jgOhYeah/TractorWatchdog/README.md

# TractorWatchdog
Engine watchdog for a Fordson Dexta tractor. Should work with other tractors as well.

Doxygen documentation is available [here](https://jgohyeah.github.io/TractorWatchdog/).

## Block diagram
Bloack diagram of the system
