jgOhYeah/TractorWatchdog/WatchdogMainUnit/Readme.md

# This CAD file contains the following models from external sources:
- [L298N motor driver](https://grabcad.com/library/l298n-21), downloaded 13/10/2023.
- [Automotive relay](https://grabcad.com/library/12v-40a-4-pin-car-relay-1), downloaded 27/12/2023.
