jgOhYeah/TractorWatchdog/WatchdogDashboard/Exports/Dashboard.step

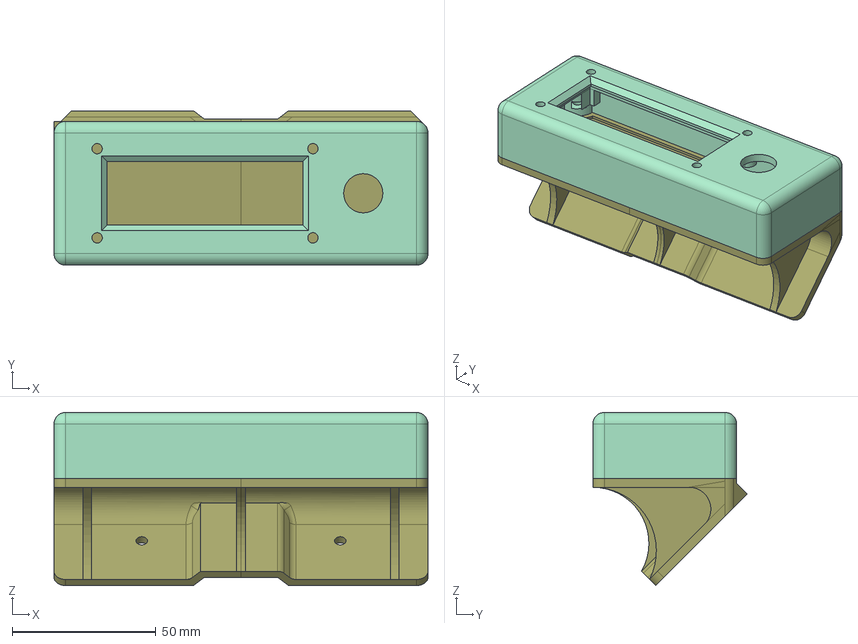
[picture p1: CAD file, 2023-10-11]
WatchdogDashboard/Exports/Dashboard.step
130.0 x 53.7 x 60.2 mm
Base
TopPart
