jgOhYeah/TractorWatchdog/WatchdogPCB/output/WatchdogPCB.step

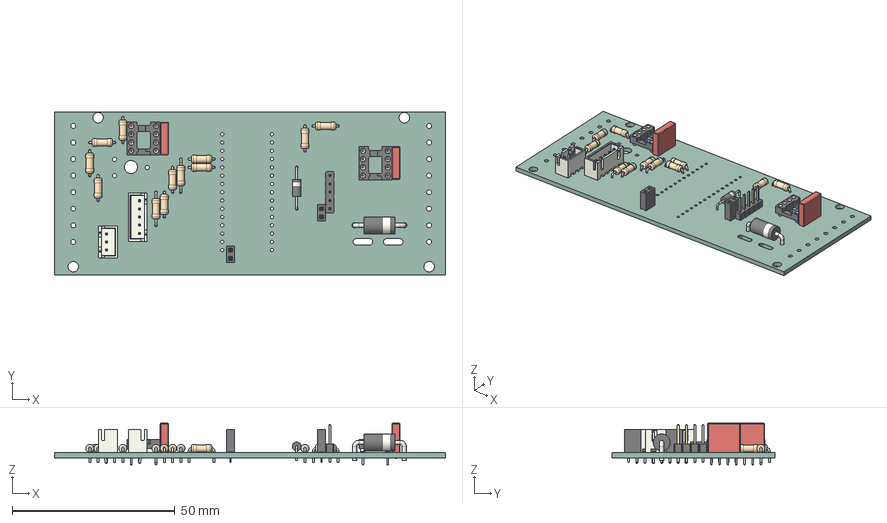
[picture p2: CAD file, 2023-12-27]
WatchdogPCB/output/WatchdogPCB.step
120.0 x 50.0 x 12.8 mm
WatchdogPCB PCB
