jgOhYeah/TractorWatchdog/(list of files, cad)

Other CAD files:
WatchdogDashboard/Dashboard.FCStd
