jgOhYeah/TractorWatchdog/WatchdogPCB/output/WatchdogPCB.pdf

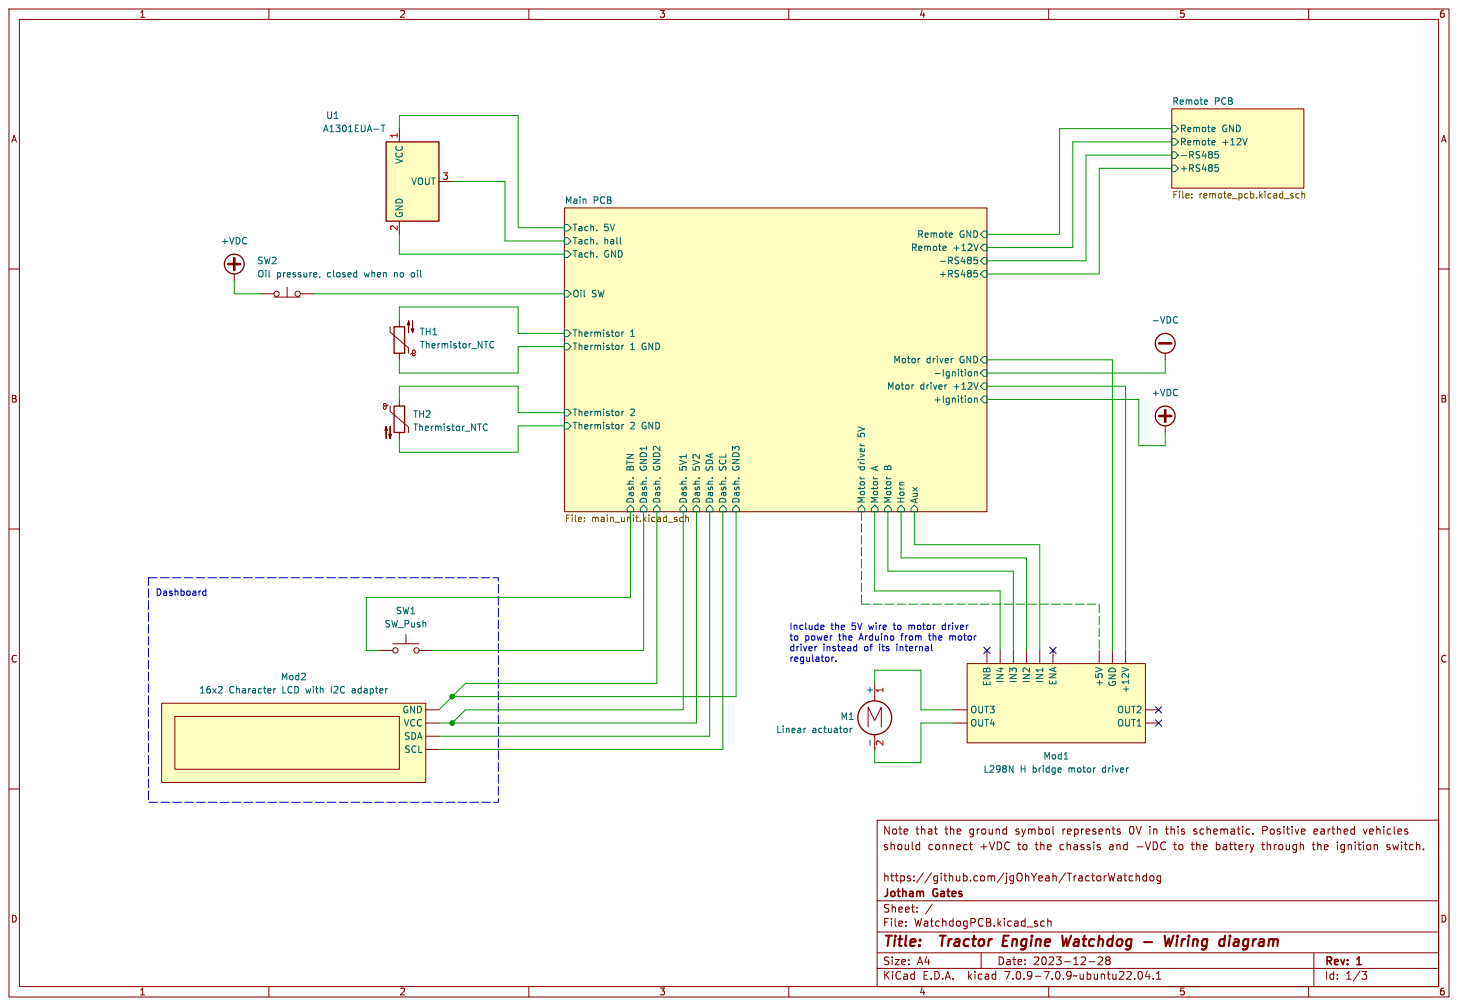
[picture p3: page 1]

1 GND
L298N H bridge motor driver VCC

+Ignition Motor driver +12V Motor driver GND

to power the Arduino from the motor driver instead of its internal regulator. Dashboard

Include the 5V wire to motor driver

https://github.com/jgOhYeah/TractorWatchdog
File: WatchdogPCB.kicad_sch Sheet: / Jotham Gates

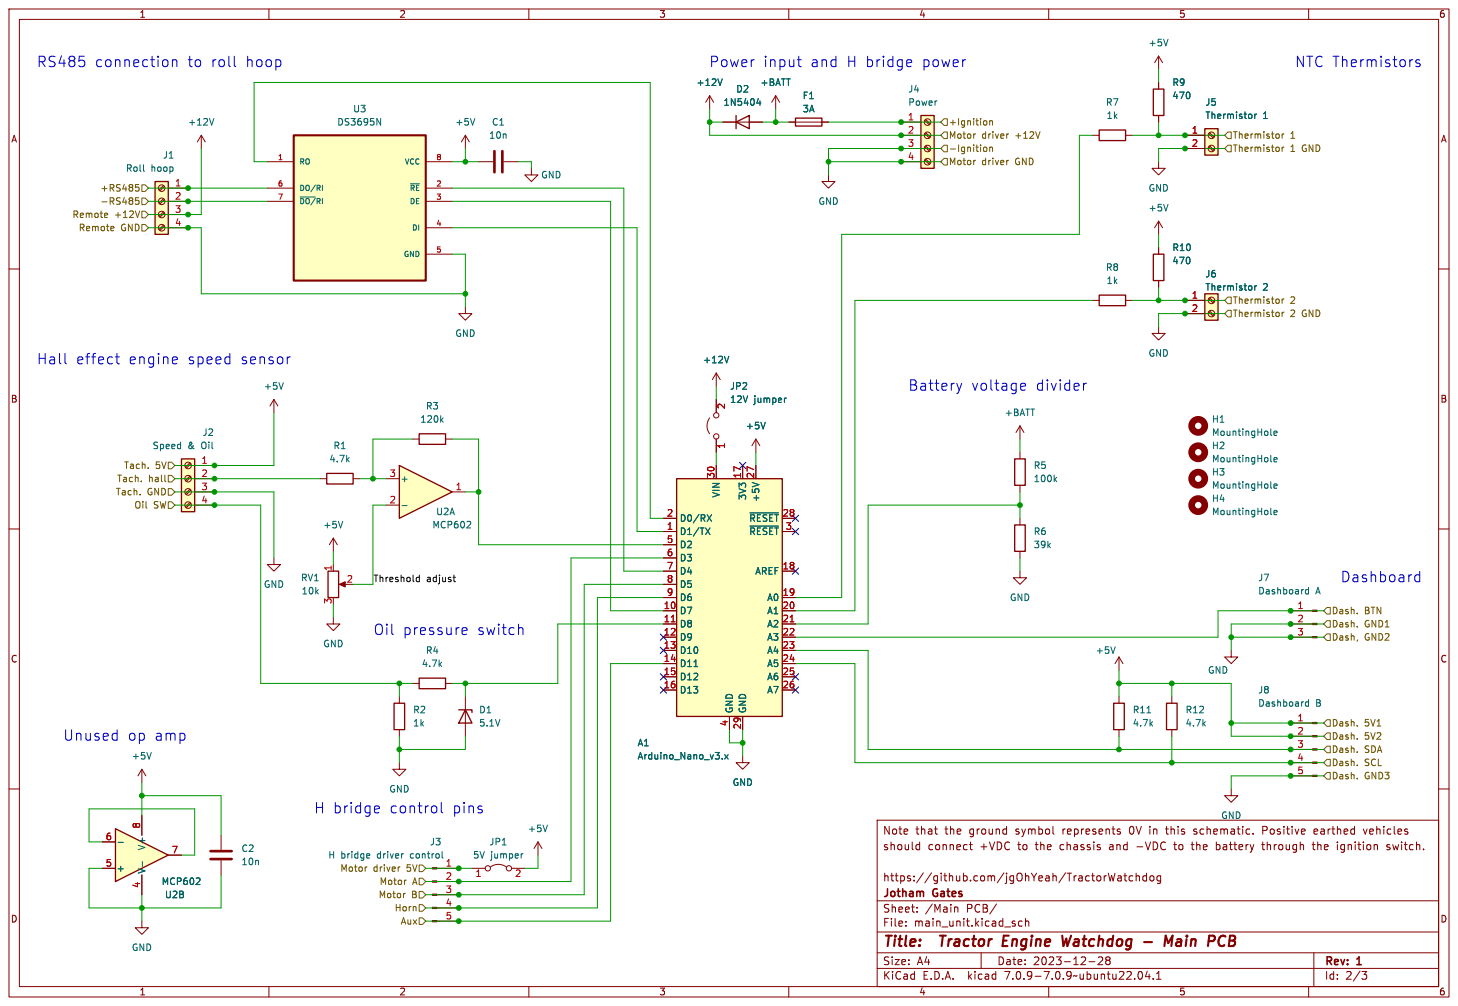
[picture p4: page 2]

Power input and H bridge power

-Ignition Motor driver GND

Tach. 5V
Tach. GND
Dash. SCL Oil SW

https://github.com/jgOhYeah/TractorWatchdog

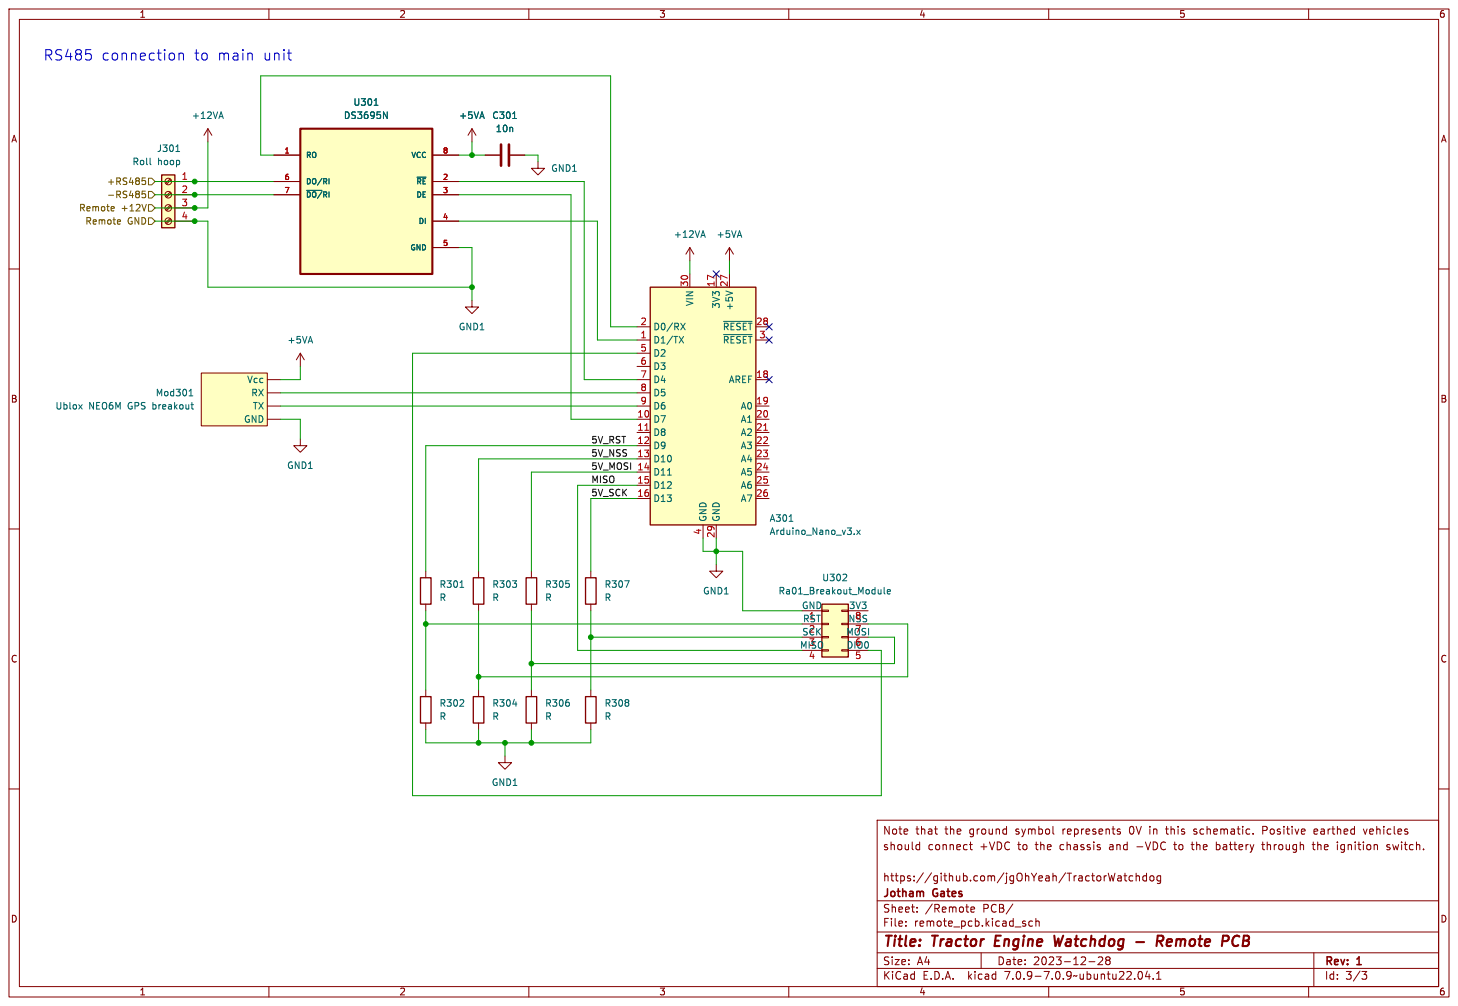
[picture p5: page 3]

https://github.com/jgOhYeah/TractorWatchdog

Id: 3/3 Title: Tractor Engine Watchdog - Remote PCB
