jgOhYeah/TractorWatchdog/WatchdogPCB/output/Pinout.pdf

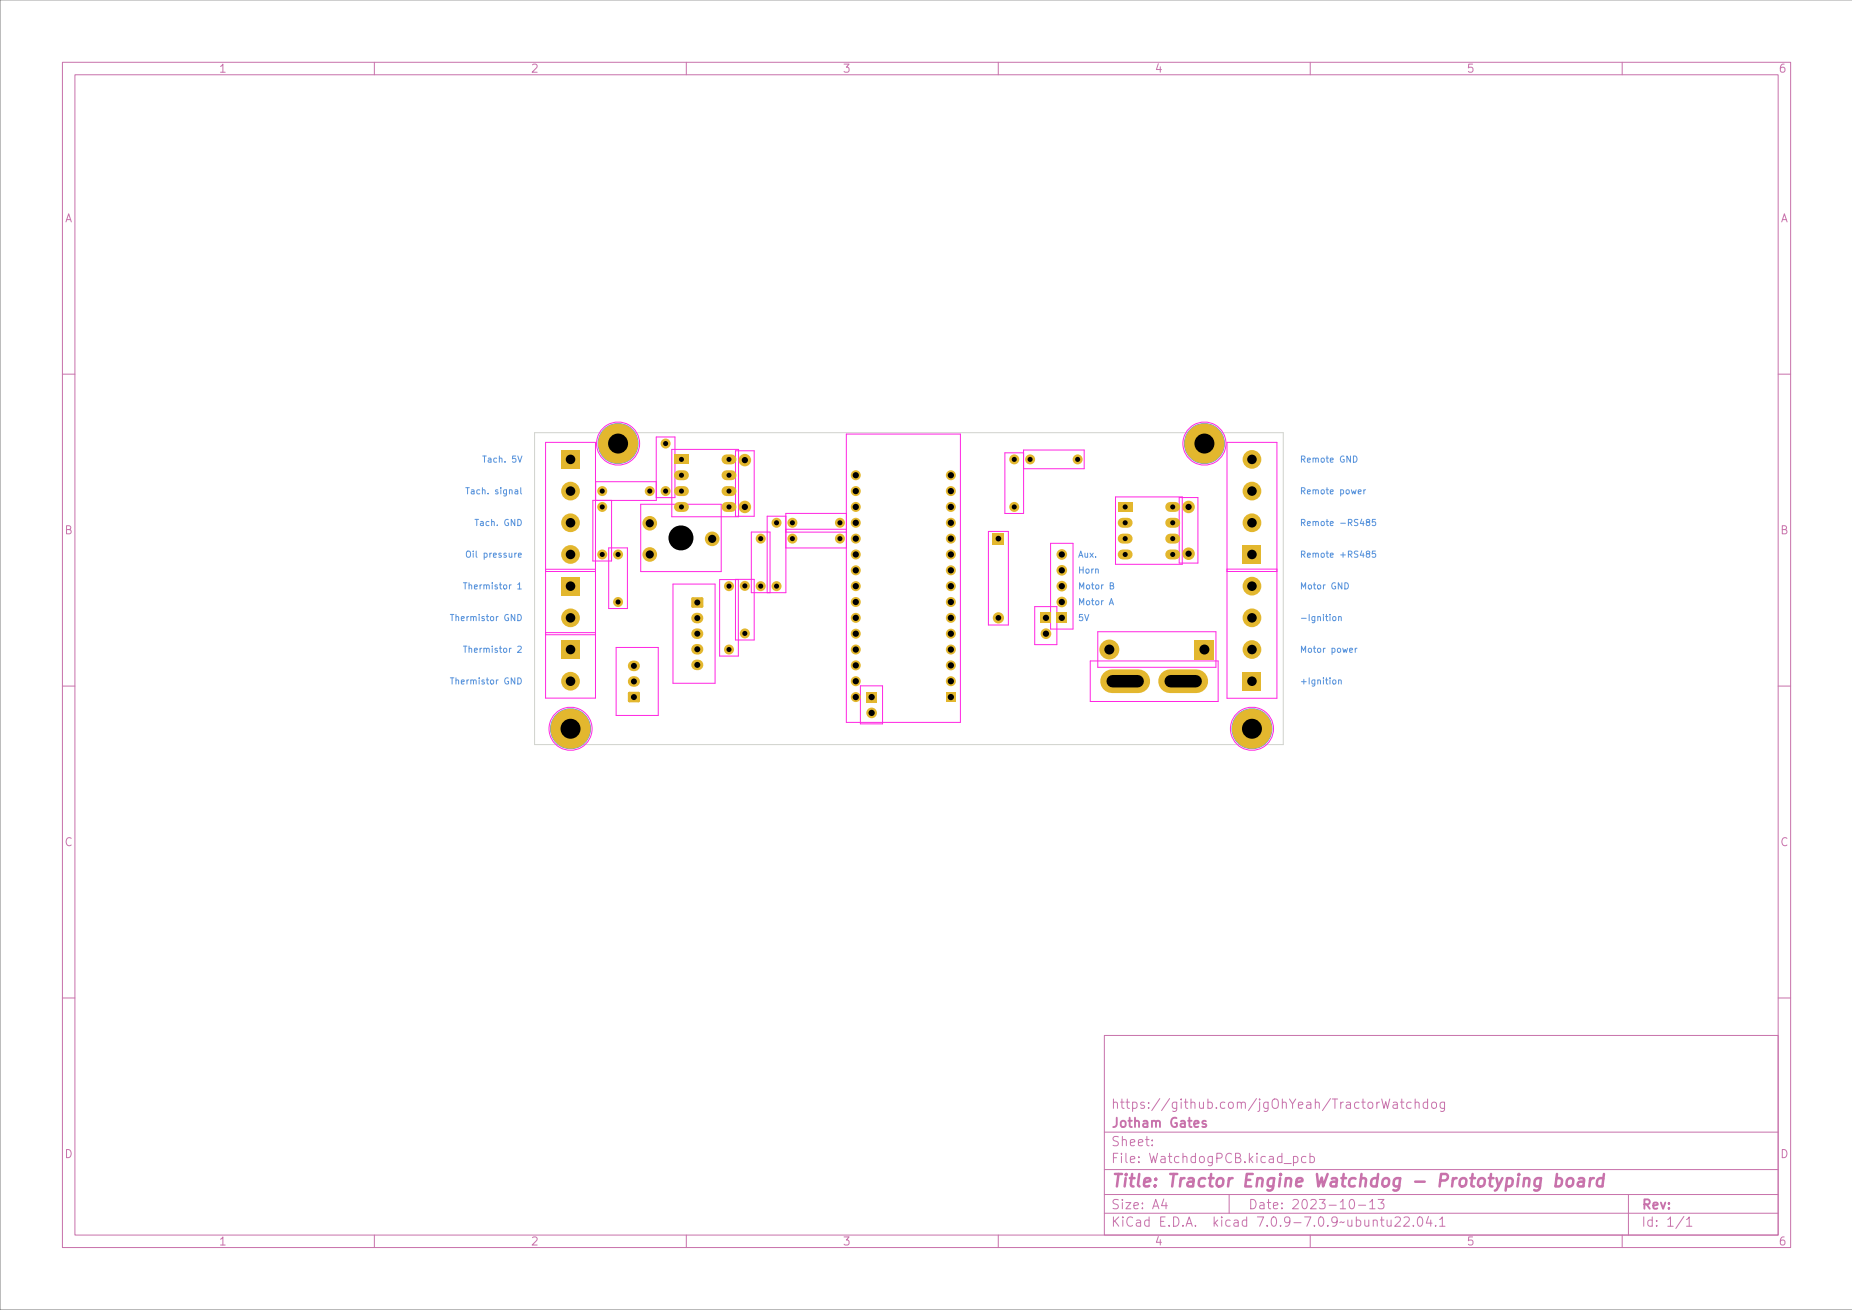
[picture p6: page 1]
