jgOhYeah/TractorWatchdog/WatchdogMainUnit/DimensionedPlate.pdf

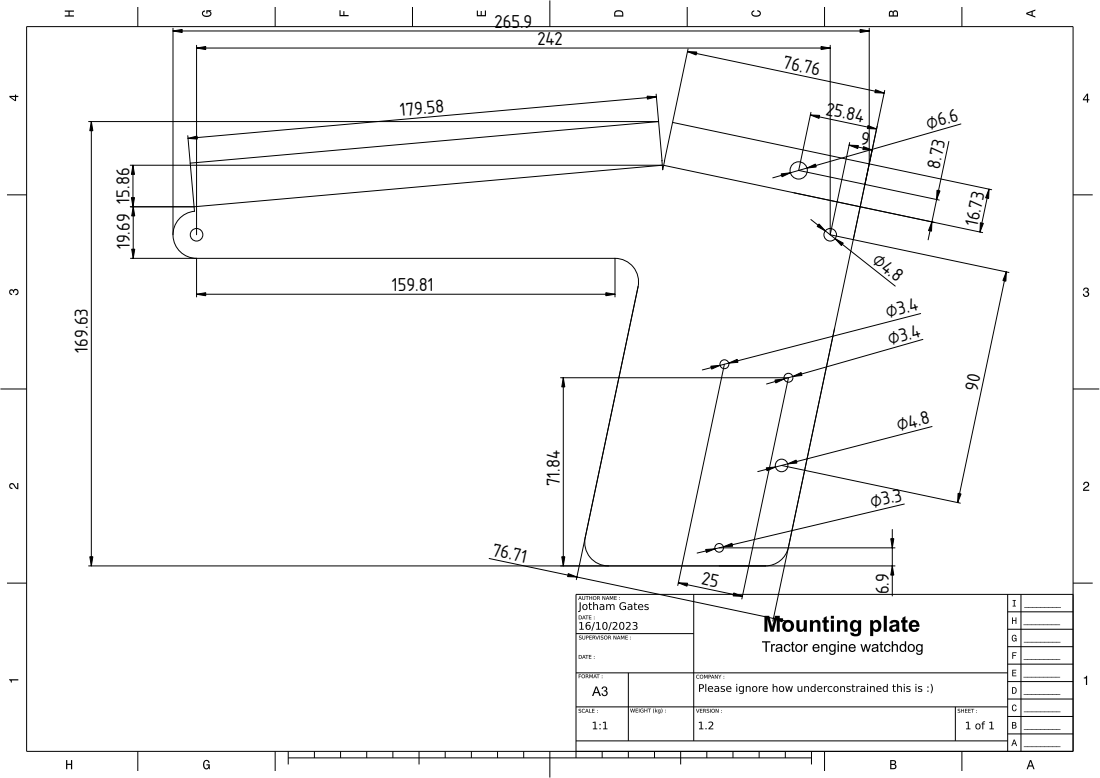
[picture p7: page 1]
