jgOhYeah/TractorWatchdog/WatchdogPCB/output/CutTracks.pdf

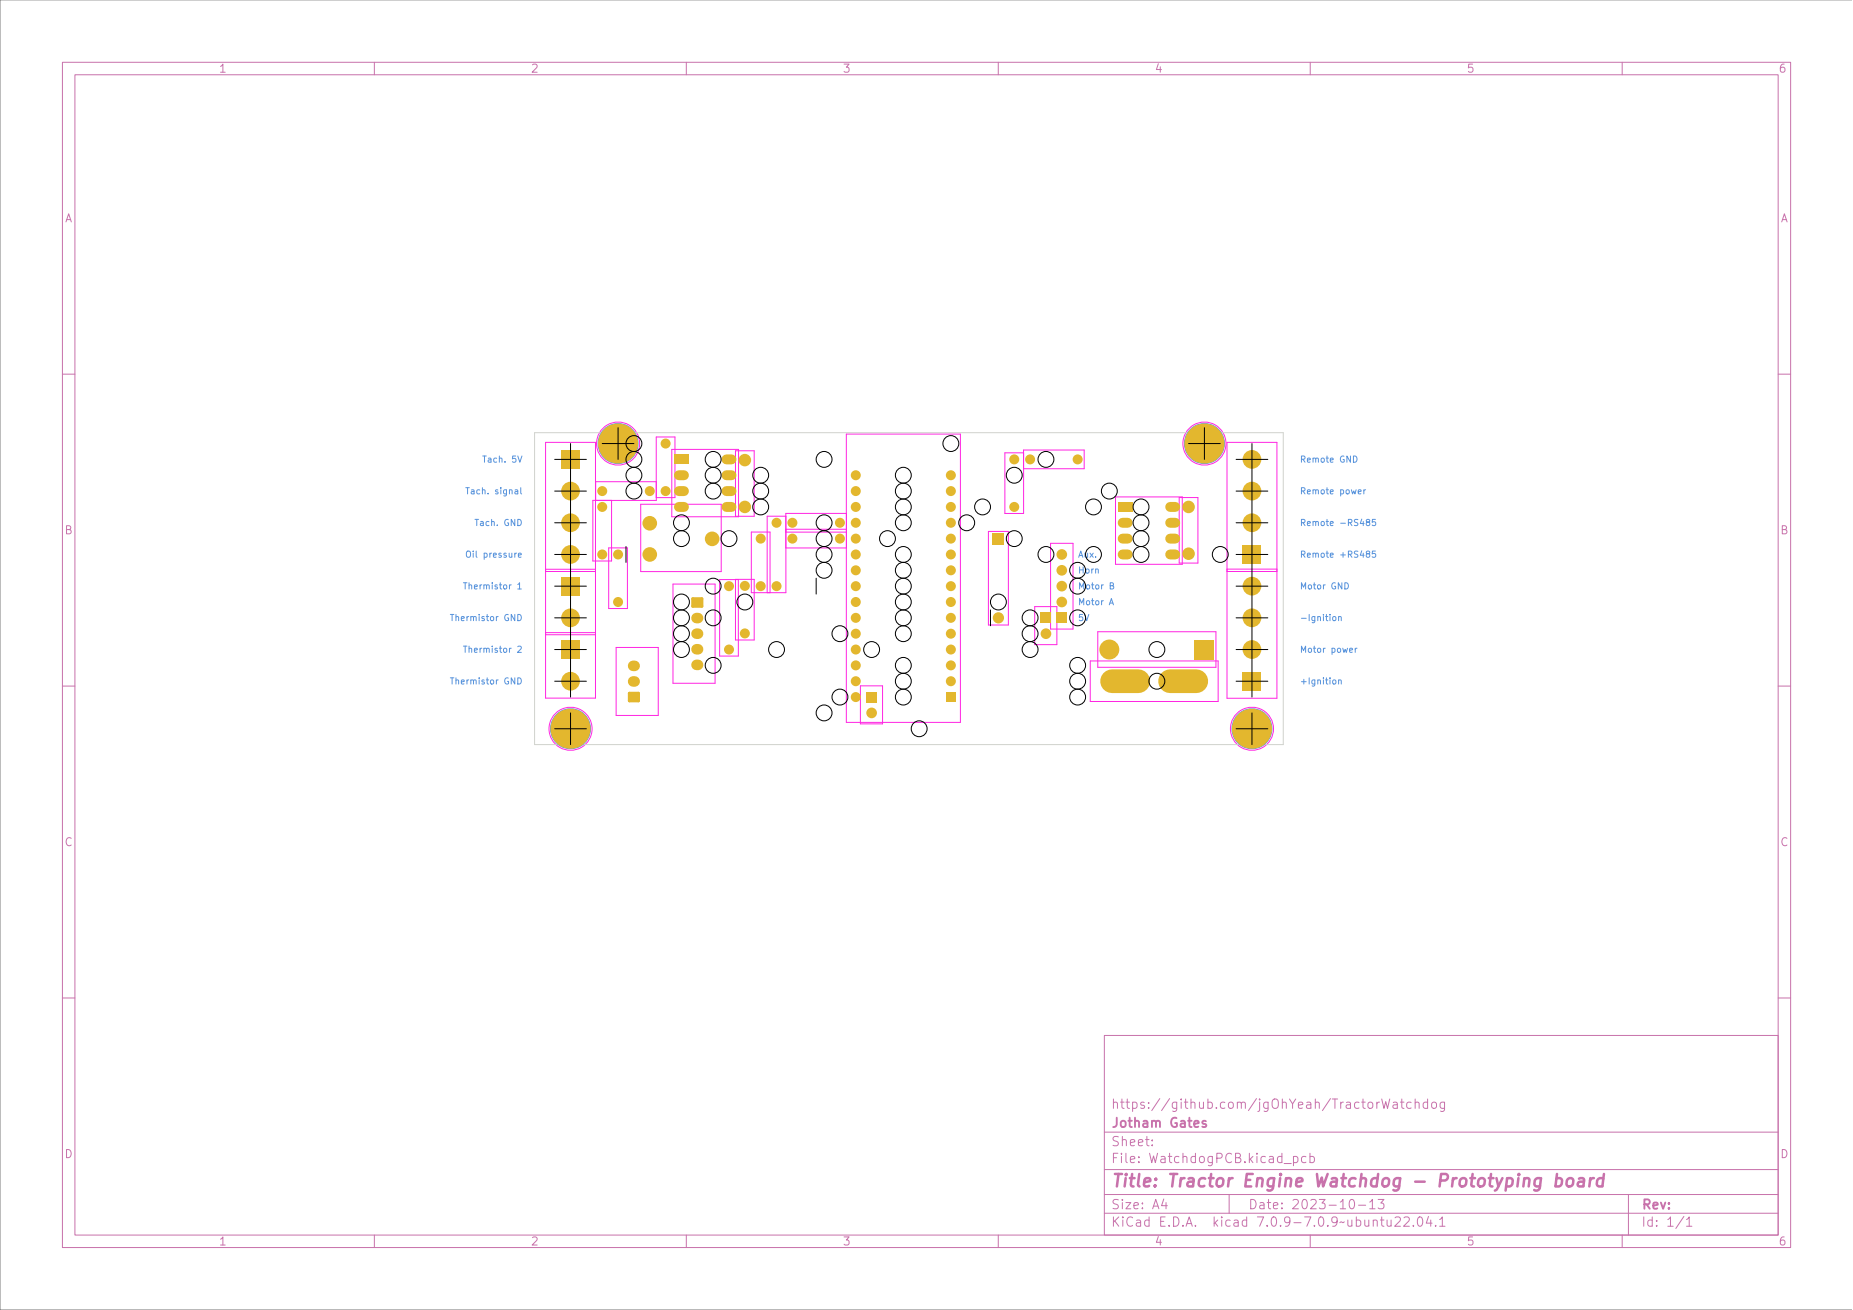
[picture p8: page 1]
