jgOhYeah/TractorWatchdog/WatchdogPCB/output/PCBLayout.pdf

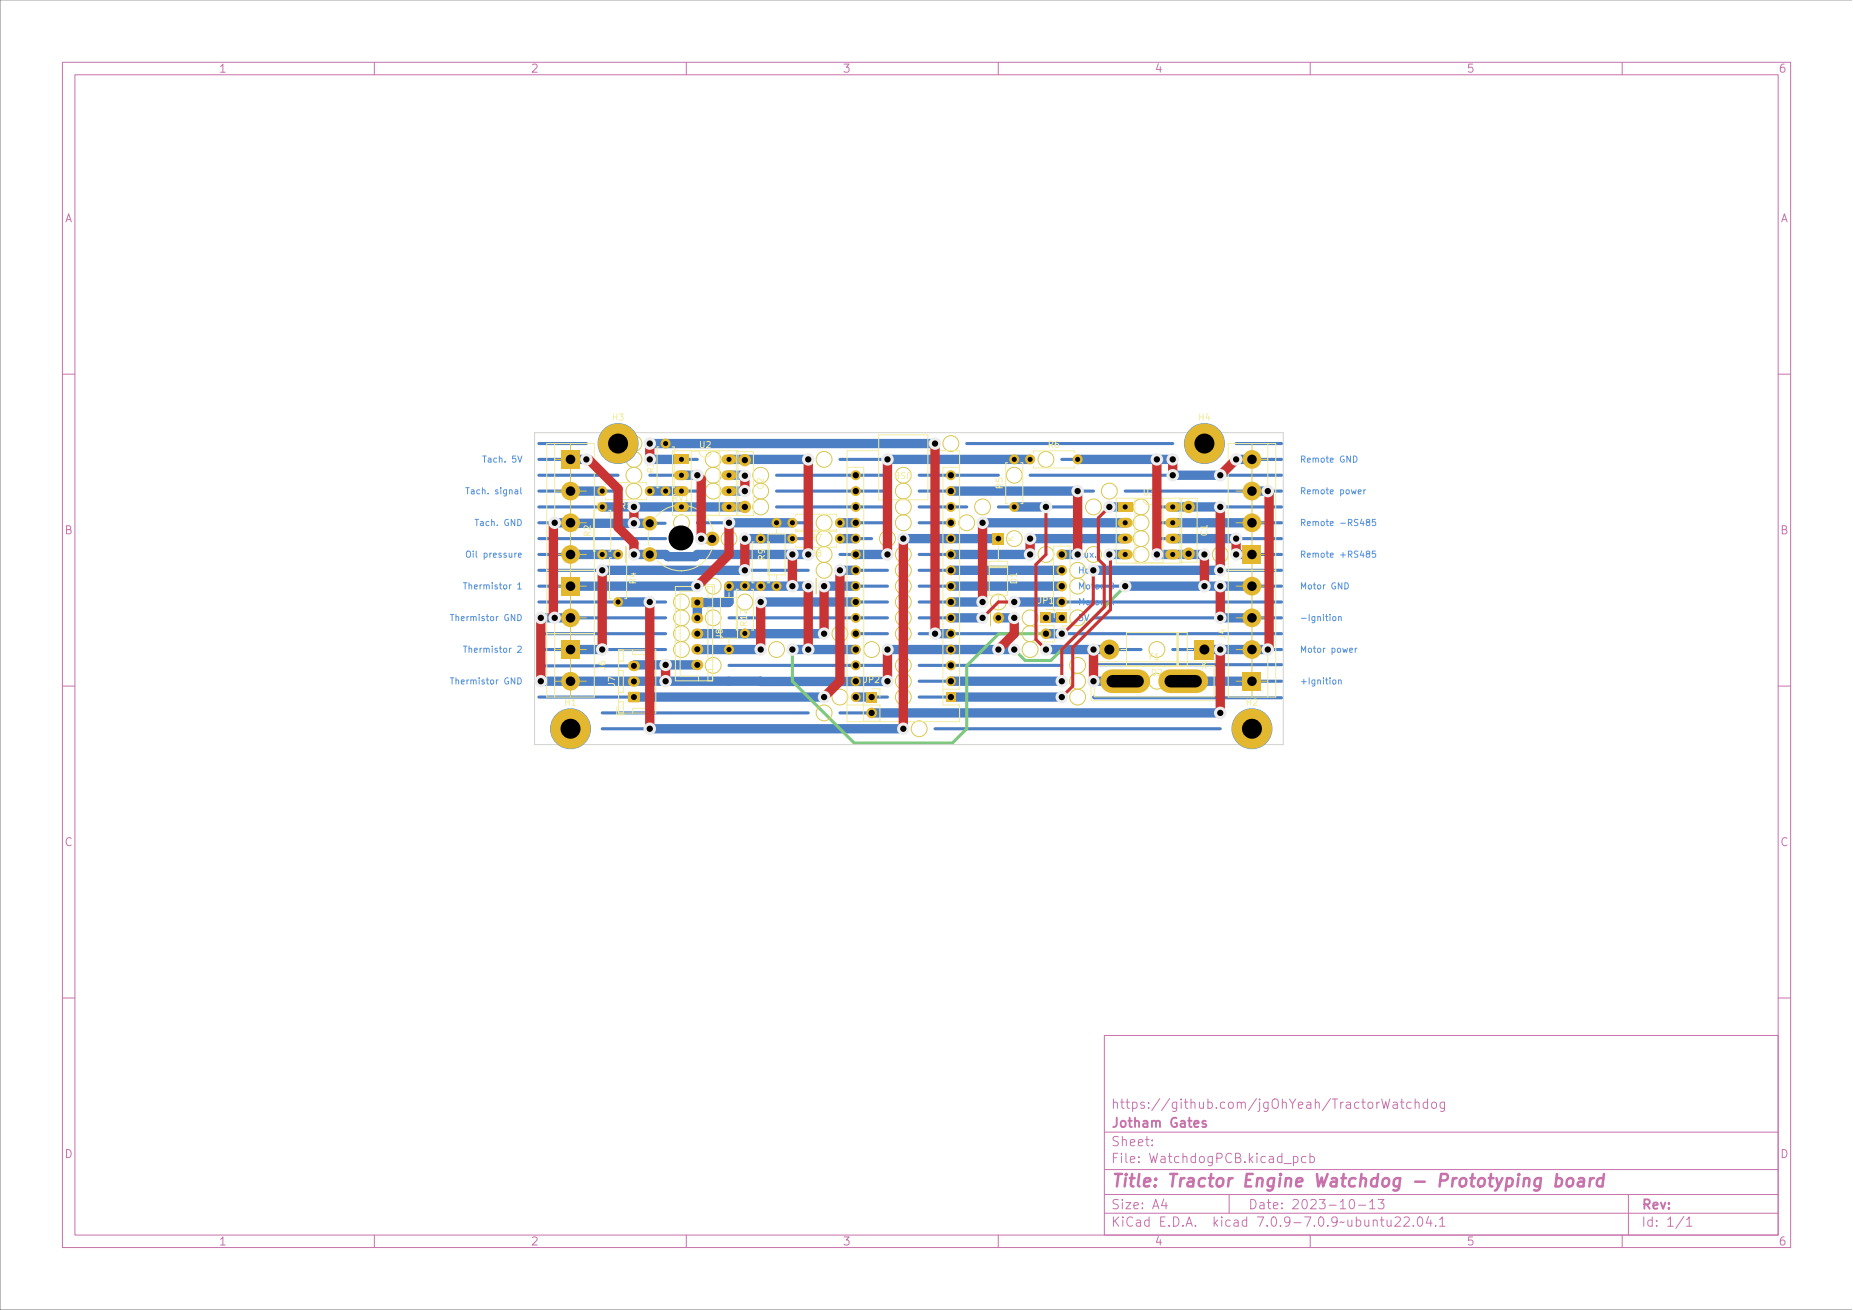
[picture p9: page 1]
