jgOhYeah/TractorWatchdog/WatchdogPCB/WatchdogPCB.kicad_pcb

## KiCad design WatchdogPCB/WatchdogPCB.kicad_pcb (2023-12-28)

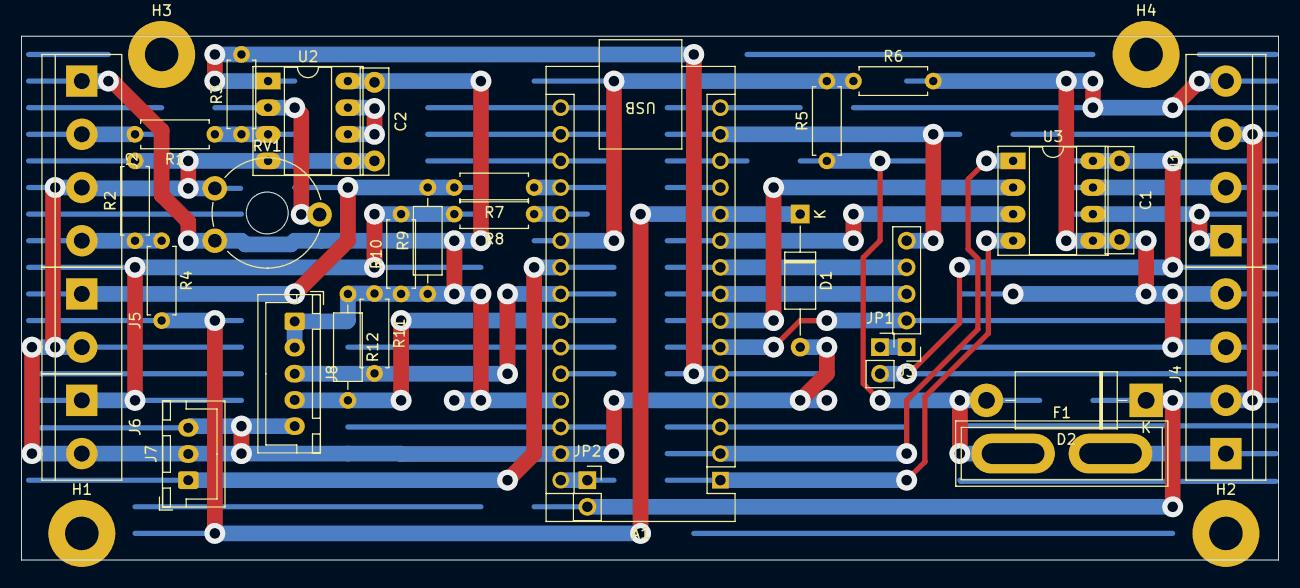
[picture p10: board WatchdogPCB.kicad_pcb from above]

Board: 4 copper layers, 120.0 x 50.0 mm, 35 parts (0 on the bottom side), 32 nets.

Parts:
A1: Arduino_Nano_v3.x; Arduino_Nano
C1, C2: 10n; C_Rect_L10.0mm_W2.5mm_P7.50mm_MKS4
D1: 5.1V; D_A-405_P12.70mm_Horizontal
D2: 1N5404; D_DO-201AD_P15.24mm_Horizontal
F1: 3A; Fuse_Blade_ATO_directSolder
H1, H2, H3, H4: MountingHole; MountingHole_3.2mm_M3_Pad
J1: Roll hoop; TerminalBlock_bornier-4_P5.08mm
J2: Speed & Oil; TerminalBlock_bornier-4_P5.08mm
J3: H bridge driver control; PinHeader_1x05_P2.54mm_Vertical
J4: Power; TerminalBlock_bornier-4_P5.08mm
J5: Thermistor 1; TerminalBlock_bornier-2_P5.08mm
J6: Thermistor 2; TerminalBlock_bornier-2_P5.08mm
J7: Dashboard A; JST_XH_B3B-XH-A_1x03_P2.50mm_Vertical
J8: Dashboard B; JST_XH_B5B-XH-A_1x05_P2.50mm_Vertical
JP1: 5V jumper; PinSocket_1x02_P2.54mm_Vertical
JP2: 12V jumper; PinSocket_1x02_P2.54mm_Vertical
R1, R4, R11: 4.7k; R_Axial_DIN0207_L6.3mm_D2.5mm_P7.62mm_Horizontal
R2, R7, R8: 1k; R_Axial_DIN0207_L6.3mm_D2.5mm_P7.62mm_Horizontal
R3: 120k; R_Axial_DIN0207_L6.3mm_D2.5mm_P7.62mm_Horizontal
R5: 100k; R_Axial_DIN0207_L6.3mm_D2.5mm_P7.62mm_Horizontal
R6: 39k; R_Axial_DIN0207_L6.3mm_D2.5mm_P7.62mm_Horizontal
R9: 470; R_Axial_DIN0207_L6.3mm_D2.5mm_P10.16mm_Horizontal
R10: 470; R_Axial_DIN0207_L6.3mm_D2.5mm_P7.62mm_Horizontal
R12: 4.7k; R_Axial_DIN0207_L6.3mm_D2.5mm_P10.16mm_Horizontal
RV1: 10k; Potentiometer_Piher_PT-10-V10_Vertical_Hole
U2: MCP602; DIP-8_W7.62mm_Socket_LongPads
U3: DS3695N; DIP-8_W7.62mm_Socket_LongPads

Connections:
+5V: A1.27 (+5V), C1.1, C2.1, J2.1, J8.1, J8.2, JP1.2 (B), R9.1, R10.1, R11.1, R12.1, RV1.1, U2.8 (V+), U3.8 (VCC)
+12V: D2.1 (K), J1.3, J4.2, JP2.2 (B)
+BATT: D2.2 (A), F1.1, R5.1
+VDC: F1.2, J4.1
/Main PCB/+RS485: J1.1, U3.6 (DO/RI)
/Main PCB/-RS485: J1.2, U3.7 (~DO/RI)
/Main PCB/Aux: A1.14 (D11), J3.5
/Main PCB/Dash. BTN: A1.22 (A3), J7.1
/Main PCB/Dash. SCL: A1.24 (A5), J8.4, R12.2
/Main PCB/Dash. SDA: A1.23 (A4), J8.3, R11.2
/Main PCB/Horn: A1.9 (D6), J3.4
/Main PCB/Motor A: A1.6 (D3), J3.2
/Main PCB/Motor B: A1.8 (D5), J3.3
/Main PCB/Motor driver 5V: J3.1, JP1.1 (A)
/Main PCB/Oil SW: J2.4, R2.1, R4.1
/Main PCB/Tach. hall: J2.2, R1.2
/Main PCB/Thermistor 1: J5.1, R7.2, R9.2
/Main PCB/Thermistor 2: J6.1, R8.2, R10.2
/Main PCB/Threshold adjust: RV1.2, U2.2 (-)
GND: A1.4 (GND), A1.29 (GND), C1.2, C2.2, D1.2 (A), J1.4, J2.3, J4.3, J4.4, J5.2, J6.2, J7.2, J7.3, J8.5, R2.2, R6.2, RV1.3, U2.4 (V-), U2.5 (+), U3.5 (GND)
unnamed: A1.19 (A0), R7.1
unnamed: A1.20 (A1), R8.1
unnamed: A1.21 (A2), R5.2, R6.1
unnamed: A1.2 (D0/RX), U3.1 (RO)
unnamed: A1.1 (D1/TX), U3.4 (DI)
unnamed: A1.5 (D2), R3.2, U2.1
unnamed: A1.7 (D4), U3.2 (~RE)
unnamed: A1.10 (D7), U3.3 (DE)
unnamed: A1.11 (D8), D1.1 (K), R4.2
unnamed: A1.30 (VIN), JP2.1 (A)
unnamed: R1.1, R3.1, U2.3 (+)
unnamed: U2.6 (-), U2.7
