jgOhYeah/TractorWatchdog/(commit log)

2023-10-03 Started PCB schematic
    [WatchdogPCB.kicad_pcb, WatchdogPCB.kicad_sch]
2023-10-03 Home and error displays started, display managing works
    [TractorWatchdog.ino, defines.h, display.cpp, display.h, state.h]
2023-10-03 Home and error displays show data
    [TractorWatchdog.ino, defines.h, display.cpp, display.h, state.h]
2023-10-03 Temperature and voltage displays should work.
2023-10-11 Started working on dashboard enclosure
    [Dashboard.FCStd]
2023-10-11 Chunky dashboard enclosure design completed
    [Dashboard-Base.stl, Dashboard-TopPart.stl, Dashboard.FCStd, Dashboard.step]
2023-10-12 Mechanical side of main unit designed
    [Dashboard.FCStd]
2023-10-12 Working on electronics enclosure
2023-10-13 Working on the schematic
    [Dashboard.FCStd, WatchdogPCB.kicad_sch]
2023-10-13 Schematic finished
    [WatchdogPCB.kicad_sch]
2023-10-13 Layout mostly done
    [WatchdogPCB.kicad_pcb, WatchdogPCB.kicad_sch]
2023-10-14 Made fold go in two parts
    [PCB_Model.FCStd, WatchdogPCB.kicad_pcb, WatchdogPCB.kicad_sch]
2023-10-14 Board layout as contructed
    [WatchdogPCB.kicad_pcb, WatchdogPCB.kicad_sch]
2023-10-15 Added button to UI
    [WatchdogPCB.kicad_pcb, WatchdogPCB.kicad_sch]
2023-10-15 Most sensors added
2023-10-15 Added state checking, motor control, init screens and bug fixes
    [TractorWatchdog.ino, button.cpp, button.h, defines.h, display.cpp, display.h, motor.cpp, motor.h]
2023-10-17 Demonstration ready
    [Dashboard.FCStd, WatchdogPCB.kicad_pcb]
2023-11-02 Tidying up, added credits display back again
    [Dashboard.FCStd, LCD_Planning.ods]
2023-12-27 Adding pinout to PCB and tidying up CAD
    [PCB_Model.FCStd, WatchdogPCB.kicad_pcb, WatchdogPCB.step]
2023-12-28 Schematics modified to use pages for wiring diagram, remote unit started, working on enclosure.
    [WatchdogPCB.kicad_pcb, WatchdogPCB.kicad_sch, main_unit.kicad_sch, remote_pcb.kicad_sch]
